Ugurmustafa97/feeding-assistant-robot-v2/images/Both_Moment.jpg

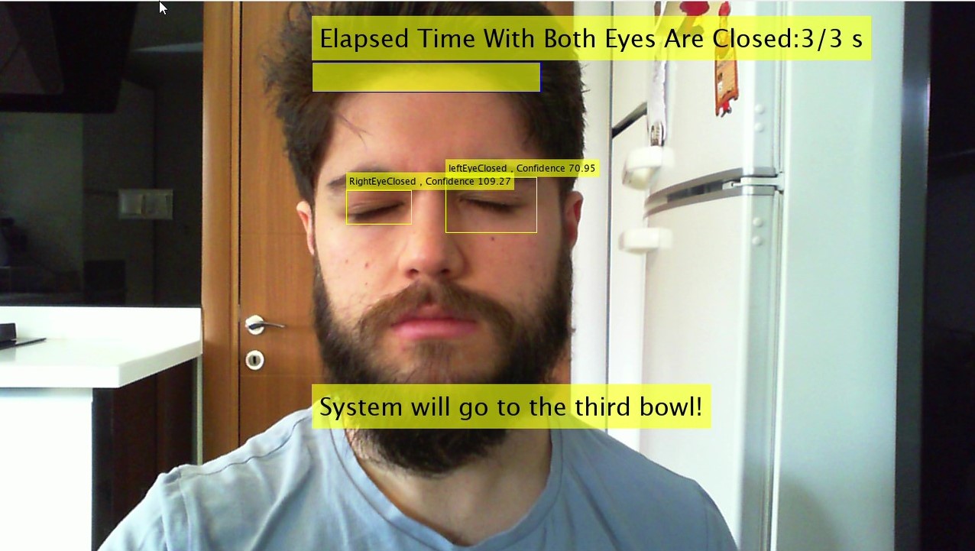
images/Both_Moment.jpg
