Ugurmustafa97/feeding-assistant-robot-v2/images/mouthTracking5.jpg

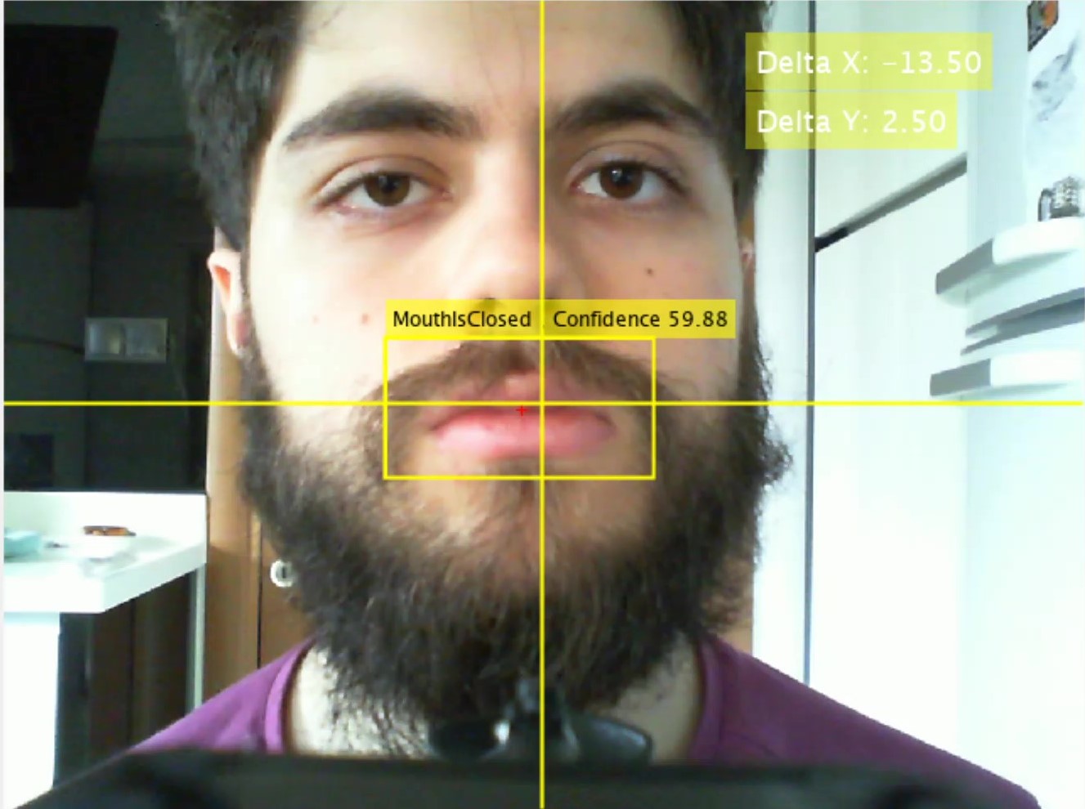
images/mouthTracking5.jpg
