Ugurmustafa97/feeding-assistant-robot-v2/cad-files/solidworks-files/manipulator_assemble_part.SLDPRT

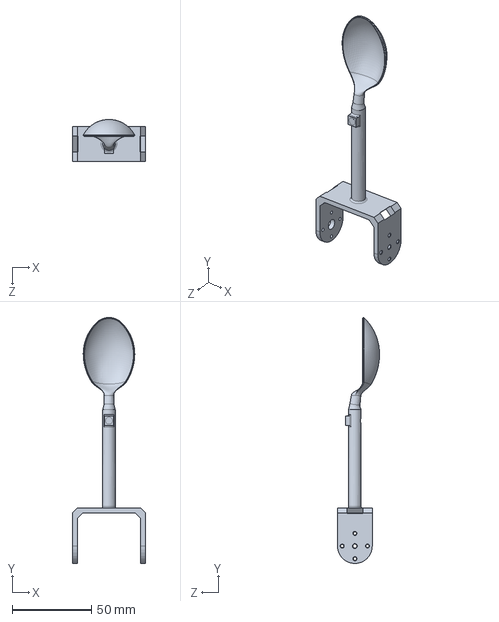
[picture p7: CAD file, 2021-01-22]
cad-files/solidworks-files/manipulator_assemble_part.SLDPRT
46.0 x 155.4 x 26.6 mm
