Ugurmustafa97/feeding-assistant-robot-v2/cad-files/solidworks-files/manipulator_spoon.SLDPRT

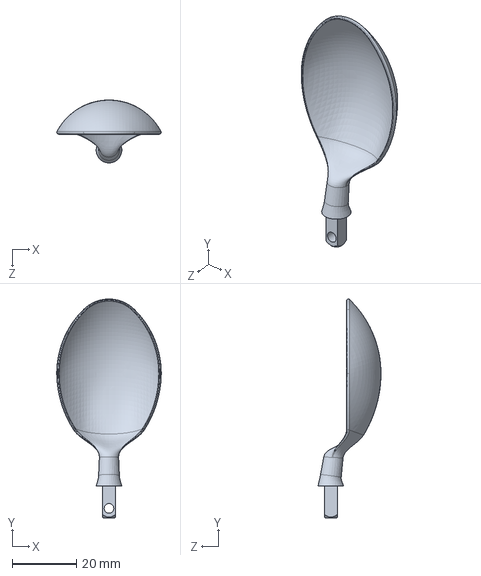
[picture p8: CAD file, 2021-01-22]
cad-files/solidworks-files/manipulator_spoon.SLDPRT
32.5 x 68.2 x 19.6 mm
