Ugurmustafa97/feeding-assistant-robot-v2/cad-files/solidworks-files/base_plate.SLDPRT

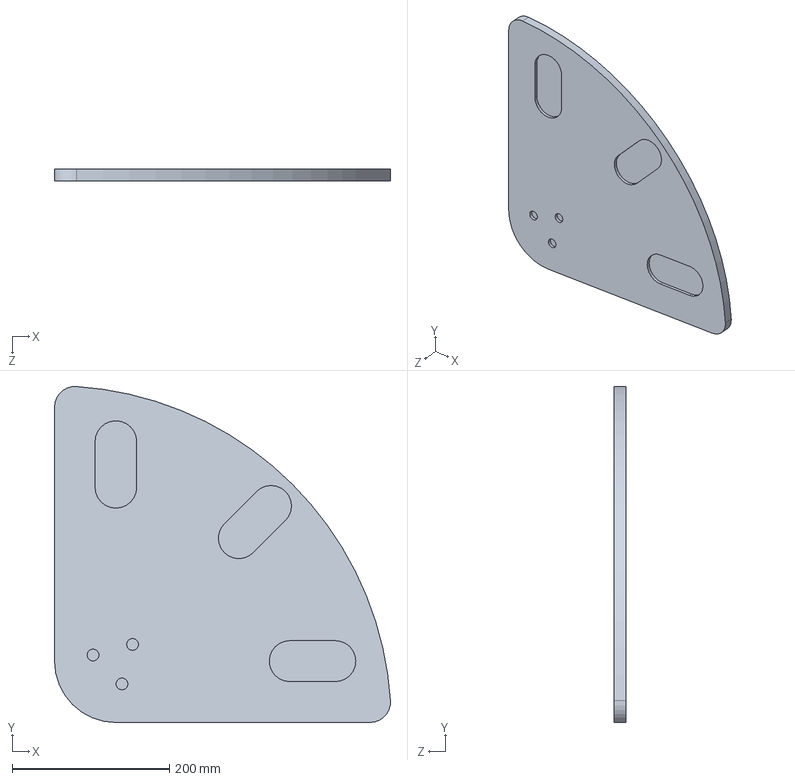
[picture p9: CAD file, 2021-01-22]
cad-files/solidworks-files/base_plate.SLDPRT
427.1 x 427.1 x 15.0 mm
