Ugurmustafa97/feeding-assistant-robot-v2/cad-files/solidworks-files/base_retainer.SLDPRT

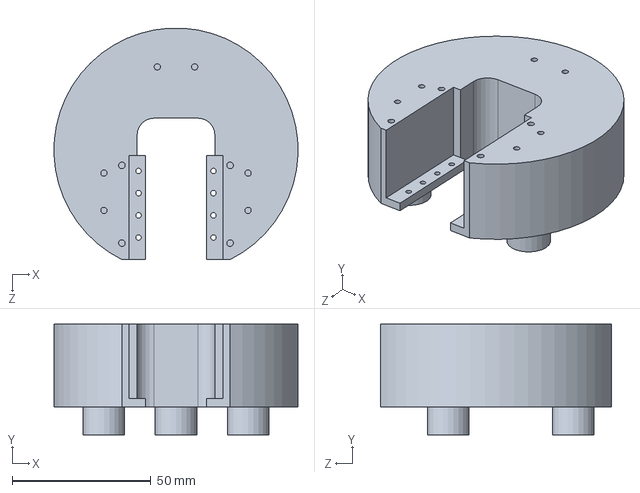
[picture p10: CAD file, 2021-01-22]
cad-files/solidworks-files/base_retainer.SLDPRT
87.9 x 39.8 x 83.4 mm
