Ugurmustafa97/feeding-assistant-robot-v2/cad-files/solidworks-files/manipulator_kit.SLDPRT

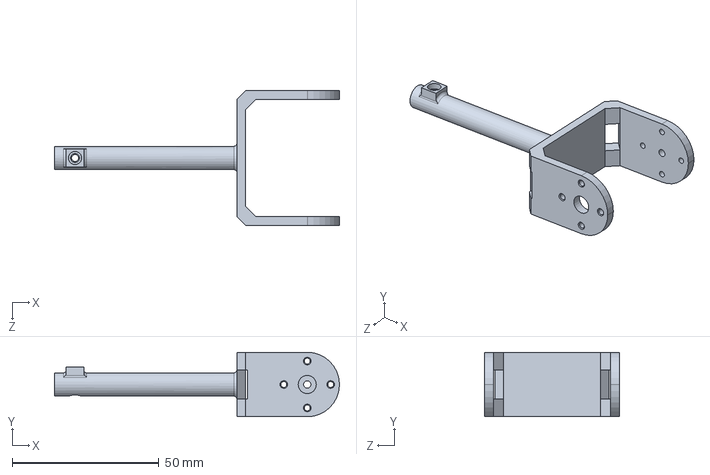
[picture p11: CAD file, 2021-01-22]
cad-files/solidworks-files/manipulator_kit.SLDPRT
97.2 x 22.0 x 46.0 mm
