Ugurmustafa97/feeding-assistant-robot-v2/cad-files/solidworks-files/link_2.SLDPRT

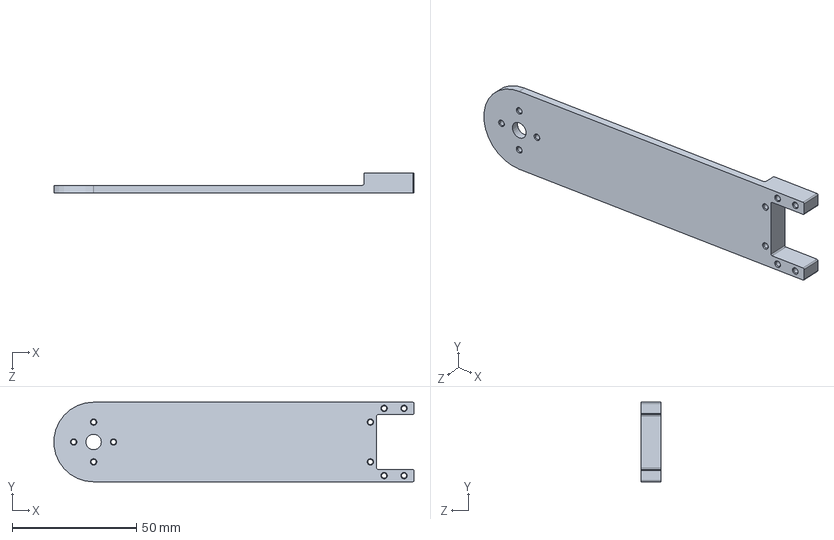
[picture p13: CAD file, 2021-01-22]
cad-files/solidworks-files/link_2.SLDPRT
144.6 x 32.0 x 8.00 mm
