Ugurmustafa97/feeding-assistant-robot-v2/cad-files/solidworks-files/manipulator_holder.SLDPRT

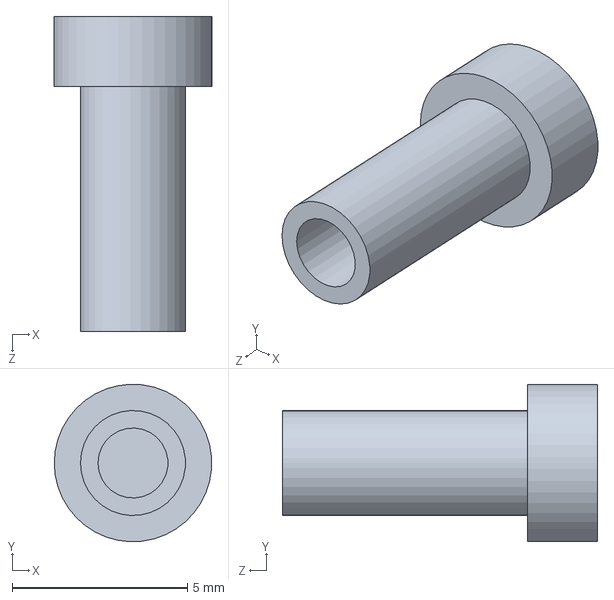
[picture p14: CAD file, 2021-01-22]
cad-files/solidworks-files/manipulator_holder.SLDPRT
4.50 x 4.50 x 9.00 mm
