Ugurmustafa97/feeding-assistant-robot-v2/cad-files/solidworks-files/connecting_kit.SLDPRT

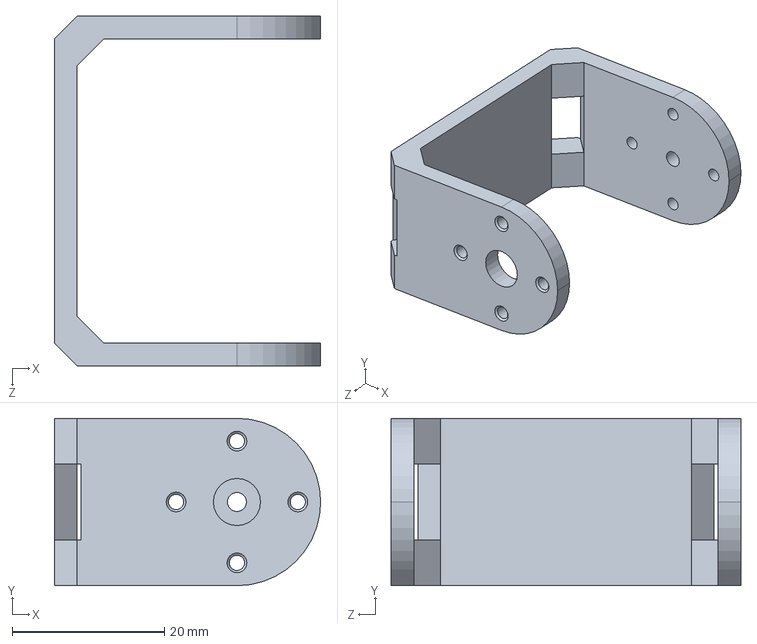
[picture p15: CAD file, 2021-01-22]
cad-files/solidworks-files/connecting_kit.SLDPRT
35.0 x 22.0 x 46.0 mm
