Ugurmustafa97/feeding-assistant-robot-v2/cad-files/solidworks-files/link_1.SLDPRT

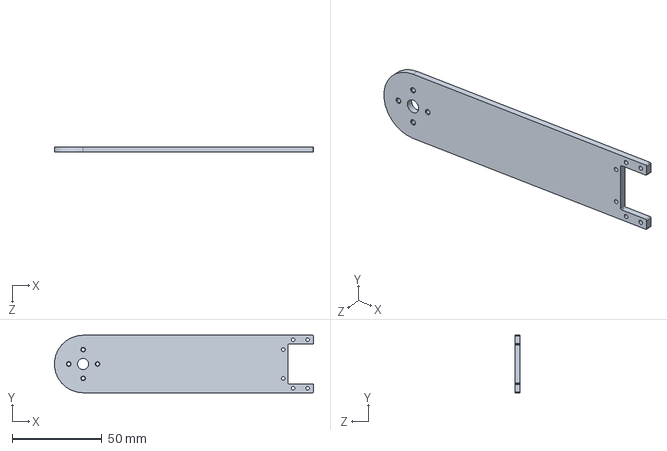
[picture p16: CAD file, 2021-01-22]
cad-files/solidworks-files/link_1.SLDPRT
143.9 x 32.0 x 3.00 mm
