Ugurmustafa97/feeding-assistant-robot-v2/cad-files/solidworks-files/connecting_holder_2.SLDPRT

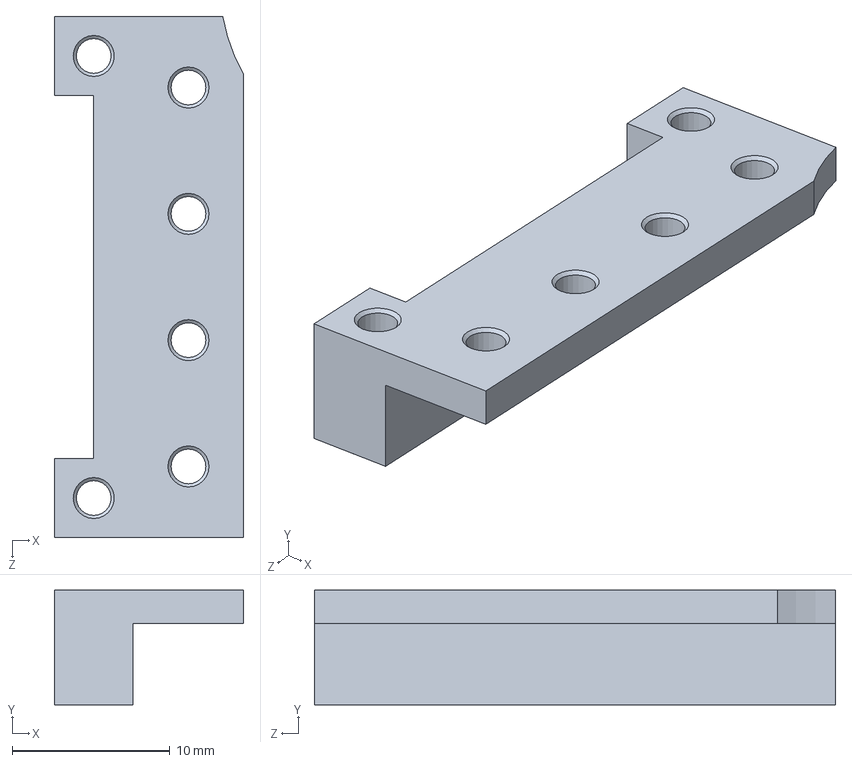
[picture p17: CAD file, 2021-01-22]
cad-files/solidworks-files/connecting_holder_2.SLDPRT
12.0 x 7.28 x 33.0 mm
