Ugurmustafa97/feeding-assistant-robot-v2/cad-files/solidworks-files/bottom_plate.SLDPRT

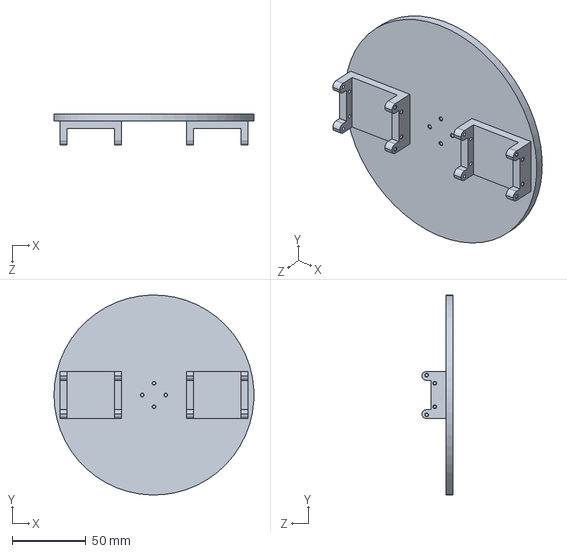
[picture p18: CAD file, 2021-01-22]
cad-files/solidworks-files/bottom_plate.SLDPRT
136.0 x 135.9 x 21.3 mm
