Ugurmustafa97/feeding-assistant-robot-v2/cad-files/solidworks-files/bowl.SLDPRT

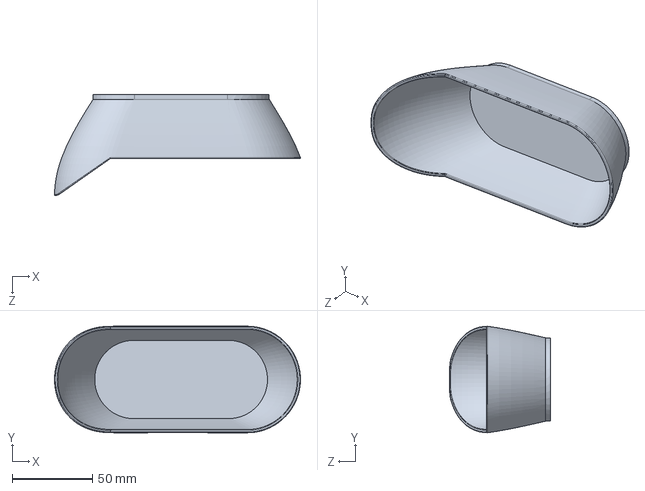
[picture p19: CAD file, 2021-01-22]
cad-files/solidworks-files/bowl.SLDPRT
153.5 x 66.5 x 63.0 mm
