Ugurmustafa97/feeding-assistant-robot-v2/(list of files, cad)

Other CAD files:
cad-files/solidworks-files/connecting_holder_1.SLDPRT
cad-files/stl-files/base_plate.STL
cad-files/stl-files/base_retainer.STL
cad-files/stl-files/bottom_plate.STL
cad-files/stl-files/bowl.STL
cad-files/stl-files/connecting_holder_1.STL
cad-files/stl-files/connecting_holder_2.STL
cad-files/stl-files/connecting_kit.STL
cad-files/stl-files/link_1.STL
cad-files/stl-files/link_2.STL
cad-files/stl-files/link_3.STL
cad-files/stl-files/manipulator_holder.STL
cad-files/stl-files/manipulator_kit.STL
cad-files/stl-files/manipulator_spoon.STL
