Ugurmustafa97/feeding-assistant-robot-v2/(commit log)

2021-01-22 camera holder image added
2021-01-22 cad-files folder added
    [base_plate.STL, base_retainer.STL, bottom_plate.STL, bowl.STL, connecting_holder_1.STL, connecting_holder_2.STL, connecting_kit.STL, link_1.STL]
2021-01-22 solidworks files are added
    [base_plate.SLDPRT, base_retainer.SLDPRT, bottom_plate.SLDPRT, bowl.SLDPRT, connecting_holder_1.SLDPRT, connecting_holder_2.SLDPRT, connecting_kit.SLDPRT, link_1.SLDPRT]
